norbertharasim/stm32-smart-fan-dht11/Core/Src/main.c

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
/* Includes ------------------------------------------------------------------*/
#include "main.h"

/* USER CODE BEGIN Includes */
#include "dht11.h"
#include "fan_controller.h"
#include <stdio.h>
#include <string.h>
/* USER CODE END Includes */

TIM_HandleTypeDef htim2;

UART_HandleTypeDef huart2;

/* USER CODE BEGIN PV */
DHT11_Data_t dhtData;
char uart_buf[160];

FanController_t fan;
/* USER CODE END PV */

void SystemClock_Config(void);
static void MX_GPIO_Init(void);
static void MX_USART2_UART_Init(void);
static void MX_TIM2_Init(void);
/* USER CODE BEGIN 0 */
const char* Fan_GetIntensityText(uint8_t duty) {
  if (duty <= 20) return "Cicho / Bieg jalowy";
  if (duty < 45)  return "Lekki nawiew";
  if (duty < 70)  return "Sredni nawiew";
  if (duty < 90)  return "Mocny nawiew";
  return "Maksymalna wydajnosc";
}
/* USER CODE END 0 */

/**
  * @brief  The application entry point.
  * @retval int
  */
int main(void)
{

  /* MCU Configuration--------------------------------------------------------*/

  /* Reset of all peripherals, Initializes the Flash interface and the Systick. */
  HAL_Init();

  /* Configure the system clock */
  SystemClock_Config();

  /* Initialize all configured peripherals */
  MX_GPIO_Init();
  MX_USART2_UART_Init();
  MX_TIM2_Init();
  /* USER CODE BEGIN 2 */
DHT11_Init();
Fan_Init(&fan, &htim2, TIM_CHANNEL_1, 3359);
Fan_SetPID(&fan, 10.0f, 0.15f, 2.0f, 22.0f);
Fan_SetOutputLimits(&fan, 20.0f, 100.0f);


  /* USER CODE END 2 */

  /* Infinite loop */
  /* USER CODE BEGIN WHILE */

  while (1)
  {
    uint8_t status = DHT11_Read(&dhtData);

    if (status == 0) {
      Fan_PID_Update(&fan, (float)dhtData.temperature, 2.0f);
      uint8_t duty = Fan_GetDuty(&fan);
      const char* intensity_text = Fan_GetIntensityText(duty);

      char bar[11];
      int bars_count = (duty + 5) / 10;
      if (bars_count > 10) bars_count = 10;

      for (int i = 0; i < 10; i++) {
        bar[i] = (i < bars_count) ? '=' : '.';
      }
      bar[10] = '\0';
      int sp_int = (int)fan.setpoint;
      int sp_dec = (int)((fan.setpoint - (float)sp_int) * 10.0f);
      if (sp_dec < 0) sp_dec = -sp_dec;

      int len = snprintf(uart_buf, sizeof(uart_buf),
      "Temp: %2d C (Zadana: %d.%d C) | Wilg: %2d %% | PWM: %3u %% [%s] -> %s\r\n",
            dhtData.temperature,
            sp_int, sp_dec,
            dhtData.humidity,
            duty,
            bar,
            intensity_text);
      HAL_UART_Transmit(&huart2, (uint8_t*)uart_buf, len, 50);
    }
    else if (status == 1) {
      HAL_UART_Transmit(&huart2, (uint8_t*)"Blad: Brak odpowiedzi z DHT11\r\n",31, 50);
    }
    else if (status == 2) {
      HAL_UART_Transmit(&huart2, (uint8_t*)"Blad: Zla suma kontrolna\r\n",26, 50);
    }
    HAL_Delay(2000);
    /* USER CODE END WHILE */

    /* USER CODE BEGIN 3 */
  }
  /* USER CODE END 3 */
}

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
