norbertharasim/stm32-smart-fan-dht11/STM32_DHT11.ioc

Mcu.UserName=STM32F407VGTx
PA1.GPIO_Label=DHT11
PA1.Signal=GPIO_Output
PA2.Signal=USART2_TX
PA3.Signal=USART2_RX
PA5.Signal=S_TIM2_CH1_ETR
