norbertharasim/stm32-smart-fan-dht11/(commit log)

2026-09-18 feat: implement DHT11 driver using DWT cycle counter and UART reporting
2026-09-28 docs: update README with architecture details, PID loop and add hardware telemetry captures
